FadiHaniHanna/pantograph-parallel-robot/docs/final_report.pdf

## Contents

1 Abstract | 3
2 Introduction | 4
3 Mechanical Design | 4
4 Inverse Position Kinematics Analysis | 6
5 Forward Position Kinematics | 8
6 Workspace Analysis | 9
7 Velocity Kinematics | 10
8 Static Force Analysis | 13
9 Trajectory Generation | 15

10 Simscape Simulation | 16
11 Hardware Implementation | 18
12 Results and Discussion | 22
13 Limitations | 23
14 Conclusion | 23
15 Future Work | 23
A MATLAB IPK Code | 24
B References | 25

## 1. Abstract

This project presents the mechanical design, kinematic analysis, simulation, and hardware implementation of a planar pantograph parallel robot used as a drawing mechanism. The robot consists of two actuated revolute joints and two passive distal links connected to a common end-effector point. The main objective is to control the end-effector position in the planar workspace and execute predefined drawing trajectories such as a straight line, circle, and infinity sign.

The report covers the mechanical structure, inverse position kinematics, forward position kinematics, velocity kinematics, static force analysis, Simscape simulation, MATLAB trajectory generation, and Arduino-based stepper motor control. A dedicated section is included for inverse position kinematics, where the desired end-effector position is converted into active motor angles. Simulation results are compared with the real hardware behavior, and the final system demonstrates the ability to execute drawing trajectories using a MATLAB-to-Arduino serial interface.

## 2. Introduction

Parallel manipulators are mechanisms in which the moving platform or end-effector is connected to the fixed base by multiple kinematic chains. Compared to serial manipulators, parallel mechanisms can provide higher stiffness, improved load distribution, and a compact structure. In this project, a planar pantograph parallel robot was designed and implemented as a drawing robot.

The purpose of the project is to analyze and control the motion of the pantograph robot so that the end-effector can follow predefined trajectories. The required work includes mechanical design, inverse and forward position kinematics, velocity kinematics, static force analysis, Simscape simulation, and real hardware execution using stepper motors controlled by Arduino.

The main objectives of this project are:

1. Design and model the pantograph parallel robot mechanically.
2. Derive the inverse position kinematics of the mechanism.
3. Verify the forward position kinematics.
4. Derive the velocity kinematics and Jacobian matrices.
5. Analyze the static force relation using virtual work and free-body diagram concepts.
6. Generate line, circle, and infinity trajectories.
7. Simulate the robot motion in Simscape.
8. Implement the motion on real hardware using MATLAB and Arduino.

## 3. Mechanical Design

The pantograph mechanism consists of four links connected by revolute joints. Links l1 and l2 are the proximal links connected directly to the two actuated base joints. Links l3 and l4 are the distal links connected to the common end-effector point P. The active joints are located at A1 and A2, while the joints at B1 and B2 are passive. The coordinate frame is placed at the midpoint O between the two active joints. The two base joints are separated by a distance d along the x-axis.

### 3.1. Robot Parameters

Table 1: Pantograph robot geometric parameters

Parameter | Description | Value
l1 | Left proximal link length | 12.5 cm
l2 | Right proximal link length | 12.5 cm
l3 | Left distal link length | 16.6 cm
l4 | Right distal link length | 16.6 cm
d | Distance between active joints | 5.8 cm

All MATLAB hardware-control calculations were performed consistently in centimeters. When simulation trajectories were generated in millimeters, the values were converted before hardware execution.

### 3.2. Coordinate System

The fixed base frame origin O is located at the midpoint between the two active joints. Therefore, the two active joint locations are:

A1 =

"
−

d
2
0
(1)

A2 =

"
d
2
0
(2)

The passive joint positions B1 and B2 are functions of the active motor angles θ1 and θ2:

B1 =

"
−

d
2 + l1 cos θ1
l1 sin θ1
(3)

B2 =

"
d
2 + l2 cos θ2
l2 sin θ2
(4)

The end-effector position is defined as:

P =

"
x
y
(5)

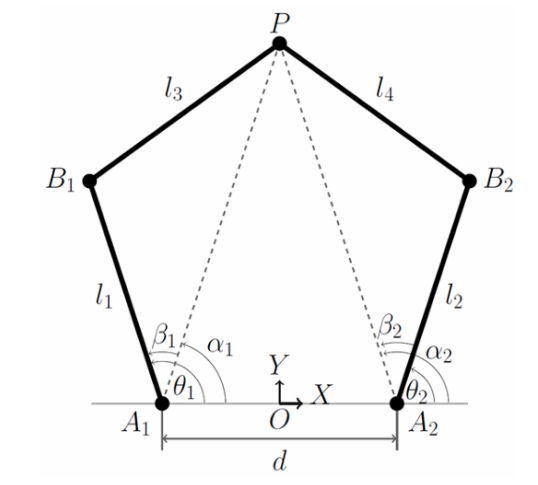
[picture p5: figure]

Figure 1: Pantograph robot geometry.

## 4. Inverse Position Kinematics Analysis

Inverse Position Kinematics (IPK) is used to determine the active joint angles required

to place the end-effector at a desired position. For the pantograph robot, the input to IPK is the desired end-effector position:

P =

"
x
y
(6)

and the output is the active joint vector:

q =

"
θ1
θ2
(7)

### 4.1. IPK Geometry

The distances from the active joints to the desired end-effector point are:

a1 =

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
a2 =

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
The angles α1 and α2 define the directions from the active joints to the end-effector point:

α1 = tan⁻¹

y
x +

d
2

!
(10)

α2 = tan⁻¹

y
x −

d
2

!
(11)

In MATLAB, the function atan2(y,x) is used instead of atan(y/x) to correctly handle all quadrants.

### 4.2. Law of Cosines

Using the law of cosines, the internal angles between the active links and the lines con-necting the active joints to the end-effector are calculated.

For the left chain:

b1 =

l

2
1 + a

2
1 − l

2
3
2l1a1

(12)

β1 = cos⁻¹
(b1) | (13)

For the right chain:

b2 =

l

2
2 + a

2
2 − l

2
4
2l2a2

(14)

β2 = cos⁻¹
(b2) | (15)

### 4.3. Active Joint Angles

The selected assembly mode for the physical robot gives:

θ1 = α1 + β1 | (16)
θ2 = α2 − β2 | (17)

This assembly mode was selected because it corresponds to the physical front-half working configuration of the robot. Points outside the reachable workspace or outside the active joint limits are rejected before trajectory execution.

### 4.4. IPK Algorithm

The IPK algorithm follows these steps:

1. Define the desired end-effector position P = [x, y]

T
2. Compute the distances a1 and a2.
3. Compute the direction angles α1 and α2.
4. Apply the law of cosines to compute β1 and β2.
5. Compute the active joint angles θ1 and θ2.
6. Check the joint limits and reject invalid configurations.

For real hardware execution, the Simscape angle offsets were not used. The Arduino receives the real IPK motor angles only.

## 5. Forward Position Kinematics

Forward Position Kinematics (FPK) calculates the end-effector position from the active

joint angles. First, the passive joint positions B1 and B2 are calculated using the active angles θ1 and θ2. Then, the end-effector point P is obtained as the intersection of two circles:

- Circle 1: center B1, radius l3
- Circle 2: center B2, radius l4

The constraints are:

|P − B1| = l3 | (18)
|P − B2| = l4 | (19)

Equivalently:

(P − B1)

T
(P − B1) = l

2
3

(20)

(P − B2)

T
(P − B2) = l

2
4

(21)

The circle intersection generally gives two mathematical solutions. The solution with the higher y-coordinate was selected because the robot operates in the front/top working

assembly mode.

To verify the FPK and IPK consistency, a test point was passed into the IPK function to obtain θ1 and θ2. These angles were then passed into the FPK function. The resulting point matched the original point with negligible numerical error, confirming the correctness of the kinematic model.

## 6. Workspace Analysis

The reachable workspace was obtained by scanning a grid of x- and y-coordinates and applying the IPK function at each point. A point was accepted only if it satisfied the link-length reachability conditions and the active joint limits.

The front-half workspace was selected because the physical robot is intended to draw in front of the motor baseline. The joint limits were also used to avoid configurations close to mechanical interference or singular behavior.


Figure 2: Reachable workspace generated in MATLAB.

## 7. Velocity Kinematics

Velocity kinematics relates the end-effector velocity to the active joint velocities. For parallel robots, the relation is obtained by differentiating the closed-loop kinematic constraints.

The active joint vector is:

q =

"
θ1
θ2
(22)

The end-effector variable vector is:

χ =

"
x
y
(23)

### 7.1. Loop Closure Equations

For the left chain:

P − B1 = l3sˆ3 | (24)

For the right chain:

P − B2 = l4sˆ4 | (25)

where ˆs3 and ˆs4 are unit vectors along the passive links B1P and B2P.

### 7.2. Differentiation of the Loop Closures

For the left chain:

P˙ − B˙
1 = l3
˙sˆ3 | (26)

Since ˆs3 is a rotating unit vector:

˙sˆ3 = ˙α3(

ˆk × sˆ3) | (27)

Therefore:

P˙ − B˙
1 = l3α˙ 3(
ˆk × sˆ3) | (28)

Dot multiplying by ˆs

T
3

eliminates the passive angular velocity because ˆs3 is perpendicular to (ˆk × sˆ3):

sˆ

T
3

(P˙ − B˙
1) = 0 | (29)

For the right chain:

sˆ

T
4

(P˙ − B˙
2) = 0 | (30)

### 7.3. Jacobian Matrices

The end-effector velocity is:

χ˙ = P˙ =

"
x˙
y˙
(31)

The active joint velocity vector is:

q˙ =

"
˙θ1
˙θ2
(32)

The passive link unit vectors are:

sˆ3 =

"
s3x

s3y

(33)

sˆ4 =

"
s4x

s4y

(34)

The velocity relation can be written as:

Jxχ˙ = Jqq˙ | (35)

where:

Jx =

"
s3x | s3y
s4x | s4y
(36)

and:

Jq =

"
l1(−s3x sin θ1 + s3y cos θ1) | 0
0 | l2(−s4x sin θ2 + s4y cos θ2)
(37)

The general Jacobian of the parallel manipulator is:

q˙ = Jχ˙ | (38)

where:

J = J

−1
q | Jx | (39)

This Jacobian gives the active joint velocities required to achieve a desired end-effector velocity.

## 8. Static Force Analysis

Static force analysis relates the actuator torques to the force applied at the end-effector. The analysis assumes static equilibrium and neglects inertial effects.

### 8.1. Virtual Work Method

The virtual work principle states that the total virtual work at static equilibrium is zero:

δW = 0 | (40)

The virtual work done by the actuators is:

δWactuators = τ

T
δq | (41)

The virtual work done by the end-effector force is:

δWexternal = F

T
δχ | (42)

Therefore:

0 = τ

T
δq − F

T
δχ | (43)

Using the Jacobian relation:

δq = Jδχ | (44)

Substitute into the virtual work equation:

0 = τ

T
Jδχ − F

T
δχ | (45)

0 = (τ

T
J − F

T
)δχ | (46)

Since the equation must hold for any virtual displacement δχ:

F

T = τ

T
J | (47)

Taking the transpose:

F = J

T
τ | (48)

Thus, the actuator torques required to produce a desired end-effector force are:

τ = J

−TF | (49)

For the planar pantograph:

F =

"
Fx
Fy
(50)

and:

τ =

"
τ1
τ2
(51)

### 8.2. Free-Body Diagram Interpretation

The same relation can be understood using a free-body diagram. The end-effector force F is balanced by the internal forces in the two passive links. Let T3 and T4 be the forces along the two passive link directions ˆs3 and ˆs4.

Force equilibrium at the end-effector gives:

T3sˆ3 + T4sˆ4 = F | (52)

In matrix form:
"
s3x | s4x
s3y | s4y

# "T3

T4

=

"
Fx
Fy
(53)

Taking moments about the active joints gives:

τ1 = T3l1(cos θ1s3y − sin θ1s3x) | (54)
τ2 = T4l2(cos θ2s4y − sin θ2s4x) | (55)

This gives the same physical result as the virtual work method.

## 9. Trajectory Generation

The robot was required to execute three task-space trajectories: a straight line, a circle, and an infinity sign. Each trajectory was first generated as a sequence of end-effector points in the x − y plane. The IPK function was then applied to convert every point into

active joint angles.

### 9.1. Linear Trajectory

A straight-line trajectory is generated using linear interpolation:

P(t) = Pstart + α(Pend − Pstart) | (56)

where:

0 ≤ α ≤ 1 | (57)

### 9.2. Circular Trajectory

A circular trajectory is generated using:

x = cx + r cos θ | (58)
y = cy + r sin θ | (59)

where (cx, cy) is the circle center and r is the radius.

### 9.3. Infinity Trajectory

Two versions of the infinity trajectory were used. The Simscape visualization used a workspace-centered infinity path with timeseries signals. The real hardware version used a batch angle trajectory sent to Arduino. The final hardware implementation was adjusted so that the physical robot starts from the same point as the Simscape trajectory.

The Simscape-style infinity equation is:

x = cx +

s cost
1 + sin²
t

(60)

y = cy +

s sin t cost
1 + sin²
t

(61)

where s is the scale of the infinity sign.

## 10. Simscape Simulation

The mechanical model was simulated in Simscape Multibody. The CAD model was im-ported into Simscape, and the active revolute joints were actuated using angle timeseries inputs generated from MATLAB. The desired infinity trajectory was first converted from task-space points into joint angles using the IPK function. These joint angles were then converted into Simscape-compatible signals.

The Simscape model required angle offsets because the Simscape revolute joint frames did not have the same zero-angle convention as the theoretical MATLAB model. Therefore, the simulation signals were generated as:

θ1,sim = θ1,matlab +

π
2

(62)

θ2,sim = θ2,matlab +

π
2

(63)

These offsets were used only for simulation. They were not sent to the real hardware.

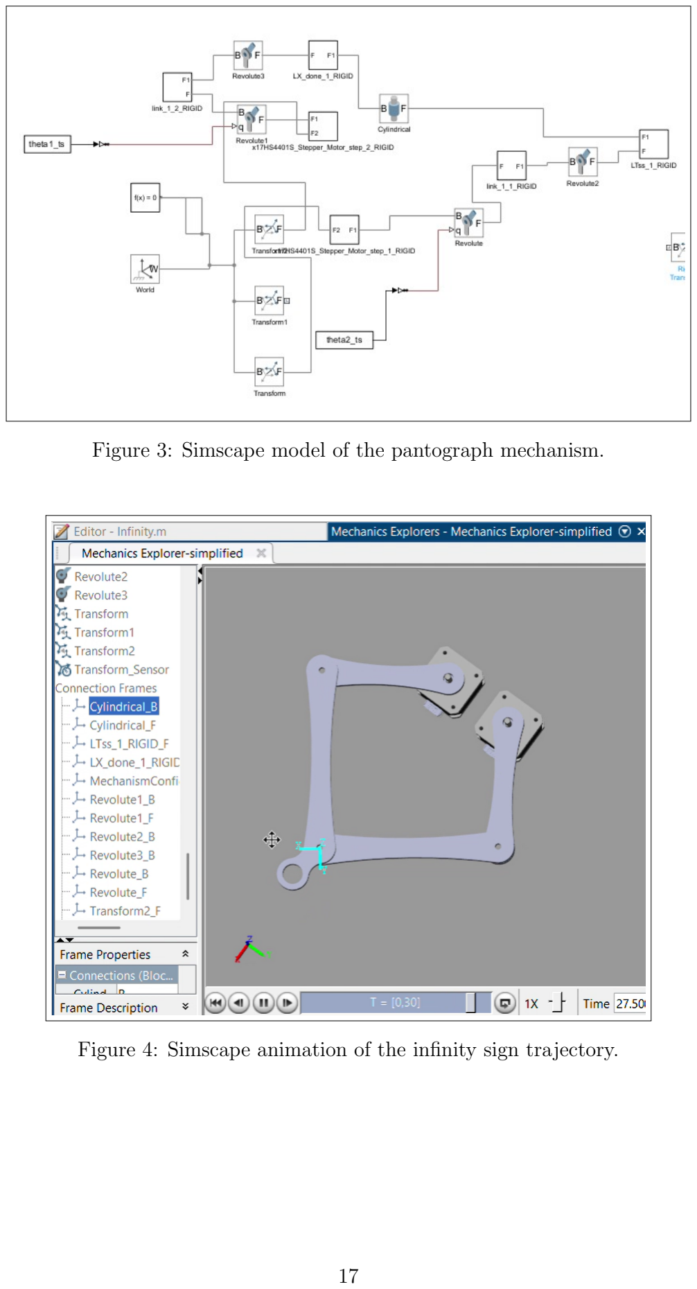
[picture p6: page 17]

Figure 3: Simscape model of the pantograph mechanism.

Figure 4: Simscape animation of the infinity sign trajectory.

## 11. Hardware Implementation

The real pantograph robot was implemented using two stepper motors driven by TMC2209 stepper motor drivers and controlled by an Arduino board. MATLAB was responsible for generating the task-space trajectory, applying the inverse position kinematics, and sending the resulting active joint angle trajectory to Arduino through serial communication. The Arduino was responsible for real-time execution by converting the received joint angles into stepper motor steps and generating the required STEP/DIR pulses.

This architecture was selected because MATLAB and USB serial communication are not suitable for generating precise real-time step pulses directly. Therefore, MATLAB was used for high-level trajectory and kinematic calculations, while Arduino handled the low-level real-time motor control.

### 11.1. Hardware Components

Table 2: Hardware components used in the real robot

Component | Function
Arduino board | Main controller for motor commands
Two NEMA 17 stepper motors | Actuated revolute joints
Two TMC2209 stepper drivers | Stepper motor driving using STEP/DIR signals
External power supply | Power source for the stepper motors
Pantograph mechanical structure | Planar parallel drawing mechanism
Pen holder | End-effector for drawing trajectories
MATLAB | Trajectory generation and inverse kinematics calculation
Arduino IDE | Uploading the low-level stepper motor control code

### 11.2. Pin Configuration

The TMC2209 drivers were controlled using STEP and DIR pins. The enable pin was shared between the two drivers. The microstepping pins were configured to set the drivers to 1/16 microstepping.

Table 3: Arduino pin configuration

Signal | Arduino Pin | Description
STEP1 | 3 | Step pulse signal for motor 1
DIR1 | 2 | Direction signal for motor 1
MS1 1 | 7 | Microstepping pin 1 for driver 1
MS2 1 | 6 | Microstepping pin 2 for driver 1
STEP2 | 9 | Step pulse signal for motor 2
DIR2 | 10 | Direction signal for motor 2
MS1 2 | 5 | Microstepping pin 1 for driver 2
MS2 2 | 8 | Microstepping pin 2 for driver 2
EN PIN | 4 | Shared enable pin for both drivers

The TMC2209 enable pin is active-low, so the drivers are enabled by setting the enable pin to LOW. The microstepping mode was set by writing both microstepping pins HIGH:

MS1 = HIGH, | MS2 = HIGH | (64)

This configuration gives 1/16 microstepping.

### 11.3. MATLAB-Arduino Serial Protocol

The communication between MATLAB and Arduino was performed using serial communication. MATLAB sends the complete trajectory to Arduino before execution. The serial command format is:

HOME,theta1,theta2

BEGIN,N

P,theta1,theta2

P,theta1,theta2

END

RUN

The purpose of each command is explained in Table 4.

Table 4: MATLAB-Arduino serial communication protocol

Command | Function

HOME,theta1,theta2 Synchronizes Arduino’s internal motor position with
| the physical home position
BEGIN,N | Tells Arduino that N trajectory points will be sent
P,theta1,theta2 | Sends one target angle pair to be stored on Arduino
END | Indicates that all trajectory points have been sent
RUN | Starts executing the stored trajectory

The HOME command does not move the motors. It only tells Arduino that the robot is currently placed physically at the known home configuration. This is important because the system is open-loop and does not use encoders. Therefore, the robot must be manually placed at the required home position before running the trajectory.

### 11.4. Angle-to-Step Conversion

The joint angles calculated by MATLAB are sent to Arduino in degrees. Arduino converts each angle into a target number of motor steps. For a standard stepper motor with 200 full steps per revolution and 1/16 microstepping, the number of microsteps per revolution

is:

Nsteps/rev = 200 × 16 = 3200 | (65)

Since one full revolution is 360◦ , the number of steps per degree is:

steps per degree = 200 × 16 × G
360

(66)

where G is the gear ratio. In this project, the gear ratio was assumed to be:

G = 1 | (67)

Therefore:

steps per degree = 200 × 16 360

= 8.8889 | (68)

The target step position for each motor is calculated as:

target steps = θdeg × 8.8889 | (69)

For example, if MATLAB sends a target angle of 90◦ , the corresponding motor step position is:

90 × 8.8889 = 800 steps | (70)

### 11.5. Trajectory Execution Logic

Instead of sending one command and waiting for the robot to stop at every point, MAT-LAB sends the full trajectory to Arduino first. Arduino stores all target angle points, converts them into step positions, and then executes the complete motion after receiving the RUN command.

This batch execution method reduces jerky motion because the Arduino controls the timing of the step pulses locally without waiting for MATLAB after every point. The execution flow is:

1. MATLAB generates the desired task-space trajectory.
2. MATLAB applies IPK to convert each point into θ1 and θ2.
3. MATLAB sends the complete angle trajectory to Arduino.
4. Arduino converts the angles into motor step positions.
5. Arduino generates synchronized STEP/DIR pulses for both motors.
6. The robot executes the desired drawing trajectory.

### 11.6. Open-Loop Calibration

Since no encoder feedback was used, the system works as an open-loop stepper motor system. This means Arduino only knows the motor position based on the number of steps commanded, not from actual measured position feedback.

Therefore, before each run, the robot must be manually placed at the correct physical home position. MATLAB calculates the joint angles corresponding to this home position and sends them using the HOME command. Arduino then stores these angles as its current internal step position.

Any error in manual homing causes an offset in the real drawing. Also, if the motors skip steps because of high speed, high friction, or excessive load, Arduino will not detect the error. This is one of the main limitations of the current hardware implementation.

## 12. Results and Discussion

The IPK and FPK were first verified numerically in MATLAB. The IPK function was used to calculate the active joint angles for a selected end-effector position, and the FPK function was then used to recover the end-effector position. The resulting error was negligible, confirming that the position kinematic model was consistent.

The Simscape simulation successfully demonstrated the pantograph motion following the desired trajectory. The infinity sign was generated in task space, converted to joint-space angles, and applied to the active revolute joints as timeseries inputs.

The hardware implementation successfully executed line and infinity trajectories. The circle trajectory required adjustment of the circle center and radius to remain within the reachable workspace. The main hardware challenges were open-loop stepper control, manual home calibration, mechanical friction, pen contact force, and small jerks due to discretized stepper movement.

The final hardware system used batch trajectory execution instead of sending one point at a time. This reduced stop-start motion because the Arduino stored the full trajectory before execution.


Figure 5: Hardware drawing result.

## 13. Limitations

The system is open-loop because no encoders or external position feedback were used. Therefore, the robot assumes that the motors do not skip steps and that the physical home position is correctly set before each run. Any error in the manual home calibration appears as an offset in the final drawing. Mechanical backlash, friction, and pen-paper contact also affect drawing accuracy.

Another limitation is that Simscape and real hardware use different angle conventions. Simscape required angle offsets due to revolute joint frame orientation, while the real robot used the actual IPK motor angles directly.

## 14. Conclusion

The project successfully developed and implemented a planar pantograph parallel robot for drawing applications. The mechanical design was modeled, and the kinematic equations were derived and verified. A dedicated IPK algorithm was developed to convert desired end-effector positions into active joint angles. FPK was used to verify the kinematic consistency, while velocity kinematics and static force analysis were derived using the Jacobian.

The robot was simulated in Simscape and implemented on real hardware using MATLAB and Arduino. MATLAB generated the desired trajectories and calculated the required motor angles, while Arduino executed the motion using stepper motor control. The final system demonstrated the ability to draw predefined trajectories, including a line and an infinity sign.

## 15. Future Work

Future improvements include adding encoder feedback for closed-loop position control, improving mechanical stiffness, reducing backlash, adding automatic homing sensors, optimizing trajectory timing, and controlling pen pressure. A camera-based feedback system could also be used to compare the drawn trajectory with the desired path and correct errors automatically.

## A. MATLAB IPK Code

1 | function theta = IPK_pantograph (q , robot )
2 | x = q (1) ;
3 | y = q (2) ;

4
5 | l1 = robot . l1 ;
6 | l2 = robot . l2 ;
7 | l3 = robot . l3 ;
8 | l4 = robot . l4 ;
9 | d | = robot . d ;

10
11 | A1 = [ - d /2 , 0];
12 | A2 = [ d /2 , 0];

13
14 | P = [x , y ];

15
16 | % Left chain
17 | v1 = P - A1 ;
18 | r1 = norm ( v1 ) ;

19
20 | alpha1 = atan2 ( v1 (2) , v1 (1) ) ;
21 | c1 = ( l1 ^2 + r1 ^2 - l3 ^2) / (2* l1 * r1 ) ;
22 | c1 = max(min( c1 , 1) , -1) ;
23 | beta1 = acos ( c1 ) ;

24
25 | theta1 = alpha1 + beta1 ;

26
27 | % Right chain
28 | v2 = P - A2 ;
29 | r2 = norm ( v2 ) ;

30
31 | alpha2 = atan2 ( v2 (2) , v2 (1) ) ;
32 | c2 = ( l2 ^2 + r2 ^2 - l4 ^2) / (2* l2 * r2 ) ;
33 | c2 = max(min( c2 , 1) , -1) ;
34 | beta2 = acos ( c2 ) ;

35
36 | theta2 = alpha2 - beta2 ;

37
38 | theta = [ theta1 ; theta2 ];
39 | end

## B. References

## References

[1] GIU Parallel Kinematics and Kinetics, Tutorial 8: Velocity Kinematics.
[2] GIU Parallel Kinematics and Kinetics, Tutorial 9: Static Forces and Virtual Work.
[3] Northwestern University Mechatronics Wiki, “Design and Control of a Pantograph

Robot,” 2010. [Online]. Available: https://hades.mech.northwestern.edu/index.

php/Design_and_Control_of_a_Pantograph_Robot. (https://hades.mech.northwestern.edu/index.php/Design_and_Control_of_a_Pantograph_Robot) Accessed: May 15, 2026.

[4] M. D. Ratolikar and P. K. R., “Optimized design of 5R planar parallel mechanism

aimed at gait-cycle of quadruped robots,” Journal of Vibroengineering, 2021. doi:

https://doi.org/10.21595/jve.2021.22131.
